Yipten/POVDisplay2/Constants.h

// serial input to shift register
#define SER 27
// output enabled (inverted)
#define OE 26
// storage register clock (rising edge)
#define RCLK 25
// shift register clock (rising edge)
#define SRCLK 33
// clear all (inverted)
#define SRCLR 32

// hall effect sensor
#define SENSOR 34

// number of LEDs
#define NUMLEDS 31

// pixel density (number of updates per degree & number of rectangular pixels)
#define DENSITY 2

// time in microseconds to offset delay between LED updates
#define DELAY_OFFSET 14
